laszlodaniel/CCDBusTransceiver/PCB/V300/schematic/CCDBusTransceiver_V300_schematic.pdf

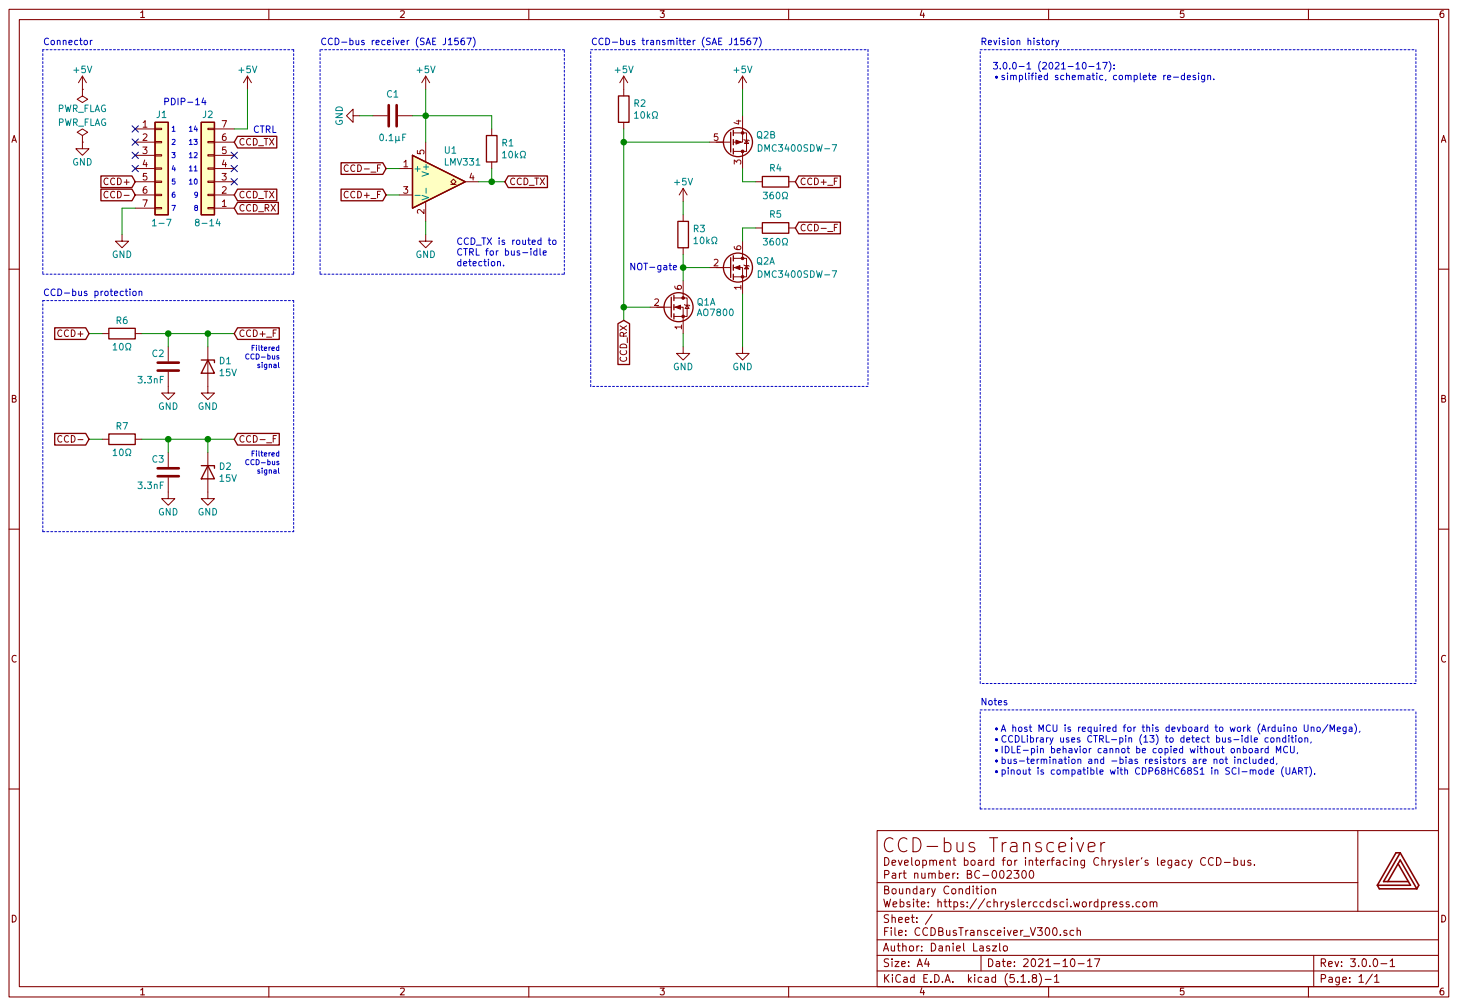
[picture p1: page 1]

CCD-bus transmitter (SAE J1567) 2

CCD-bus receiver (SAE J1567)

simplified schematic, complete re-design.

Filtered CCD-bus
signal Filtered CCD-bus

CCDLibrary uses CTRL-pin (13) to detect bus-idle condition,
IDLE-pin behavior cannot be copied without onboard MCU, bus-termination and -bias resistors are not included, pinout is compatible with CDP68HC68S1 in SCI-mode (UART).

CCD-bus Transceiver
Part number: BC-002300 Development board for interfacing Chrysler's legacy CCD-bus.

File: CCDBusTransceiver_V300.sch Sheet: / Boundary Condition Author: Daniel Laszlo Website: https://chryslerccdsci.wordpress.com
