laszlodaniel/CCDBusTransceiver/PCB/V103/schematic/CCDBusTransceiver_V103_schematic.pdf

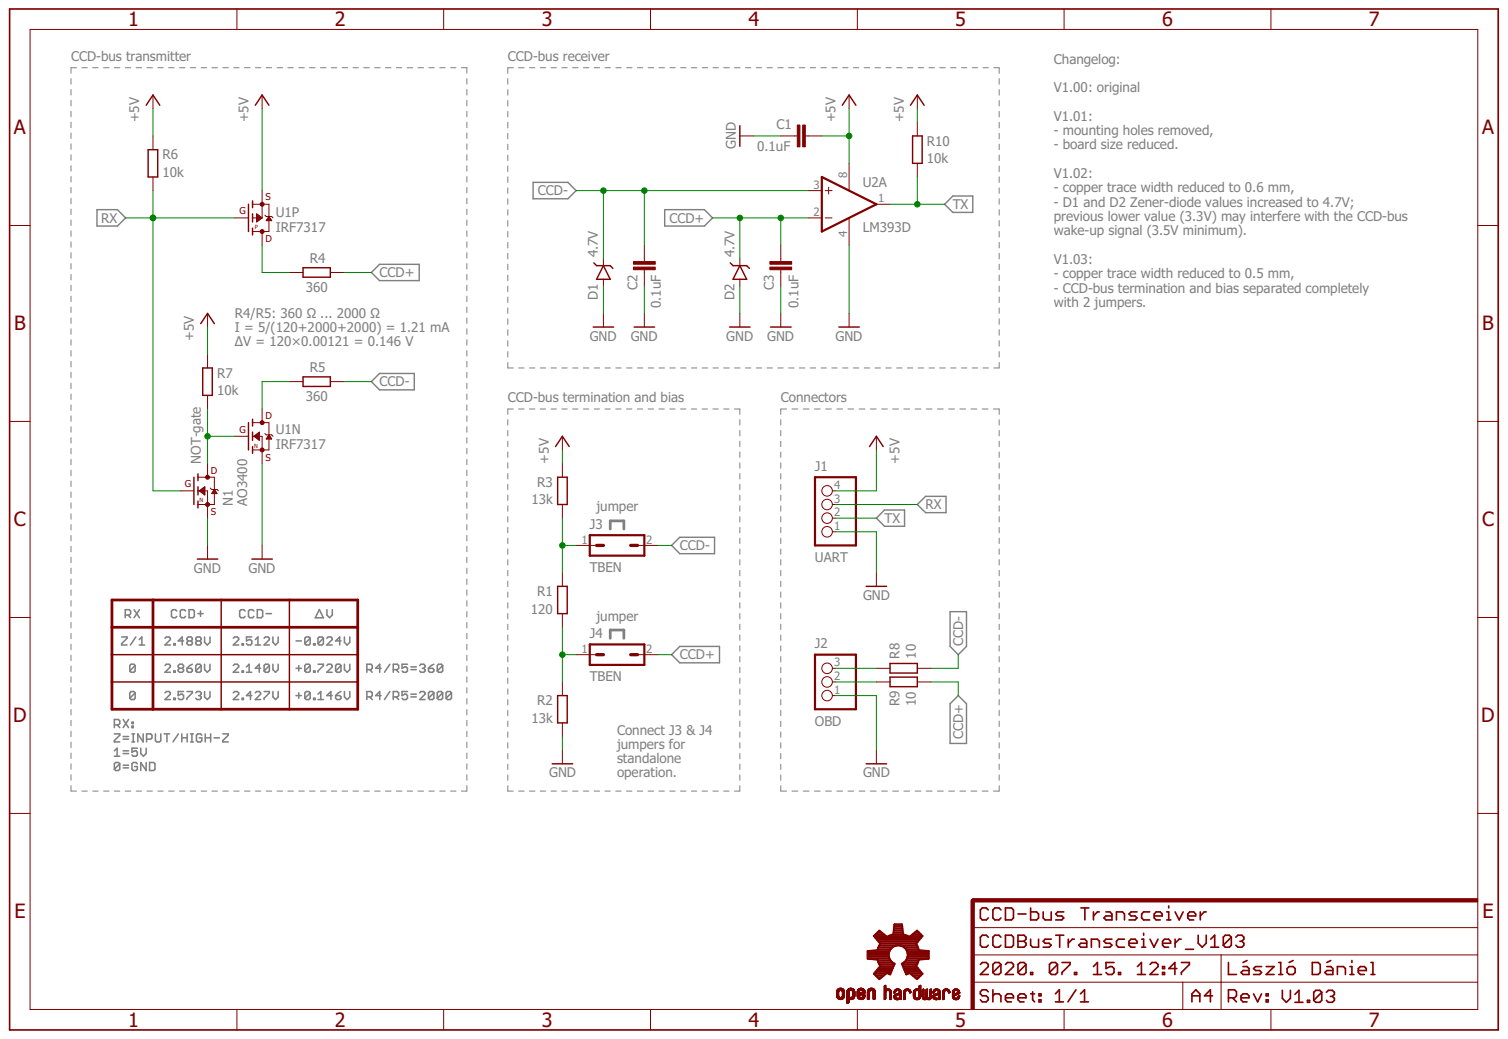
[picture p2: page 1]

CCD-bus transmitter | | CCD-bus receiver

V1.01: - mounting holes removed, - board size reduced. V1.02: - copper trace width reduced to 0.6 mm, - D1 and D2 Zener-diode values increased to 4.7V;

previous lower value (3.3V) may interfere with the CCD-bus wake-up signal (3.5V minimum). V1.03: - copper trace width reduced to 0.5 mm, - CCD-bus termination and bias separated completely with 2 jumpers. CCD-bus termination and bias

Connect J3 & J4
jumpers for standalone operation.
