laszlodaniel/CCDBusTransceiver/PCB/V101/schematic/CCDBusTransceiver_V101_schematic.pdf

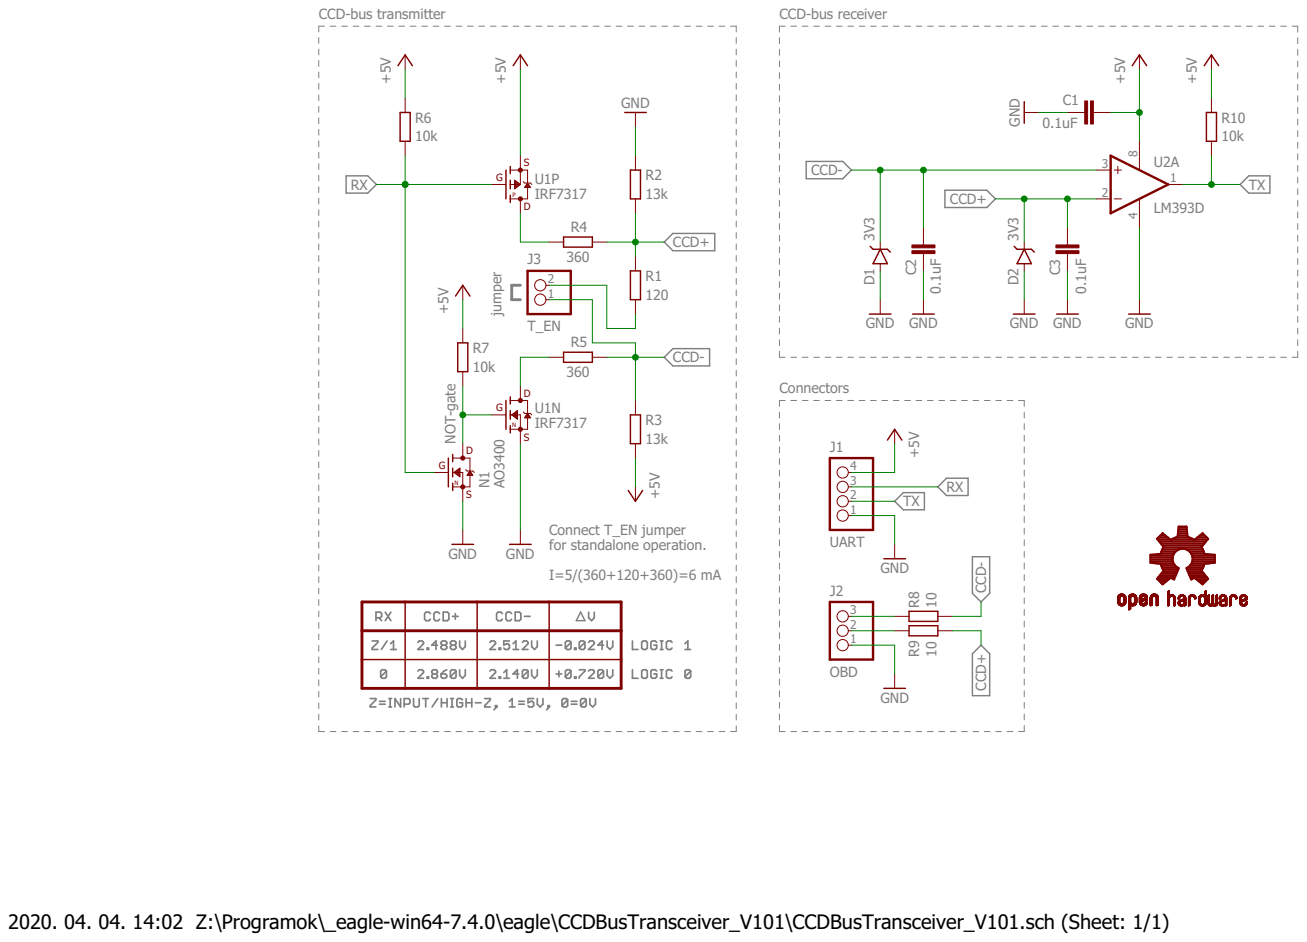
[picture p3: page 1]

Connect T_EN jumper
for standalone operation. I=5/(360+120+360)=6 mA

2020. 04. 04. 14:02 Z:\Programok\_eagle-win64-7.4.0\eagle\CCDBusTransceiver_V101\CCDBusTransceiver_V101.sch (Sheet: 1/1)
