laszlodaniel/CCDBusTransceiver/(threads)

Thread 1 (2020-04-23):

Inconsistent dominant voltage values (0-bit) among documentations

laszlodaniel, 2020-04-23:
From the CDP68HC68S1 datasheet (0.6V):
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

From another source (0.1V):
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

I think the latter is closer to reality. With R4 and R5 resistors this voltage drop across the termination resistor (R1) can be set easily.
