laszlodaniel/CCDBusTransceiver/(commit log)

2020-04-04 New PCB version
    Mounting holes removed, they are useless anyways. Routing optimized.
    [CCDBusTransceiver_V100.drills.xln, CCDBusTransceiver_V101.drills.xln]
2020-04-29 Update
    Arduino examples moved to the CCDLibrary repository.
    README.md updated.
2020-06-10 New PCB revision
    Minor changes. Check schematic for changelog.
    [CCDBusTransceiver_V102.drills.xln]
2020-07-17 Add V103 version
    [CCDBusTransceiver_V103.drills.xln]
2020-12-21 Update CCDBusTransceiver_V103_BOM.txt
    R4/R5 resistance values fixed at 360 Ohm. Package name clarified.
2021-06-13 Remove Gerber files
    [CCDBusTransceiver_V101.drills.xln, CCDBusTransceiver_V102.drills.xln, CCDBusTransceiver_V103.drills.xln]
2021-11-04 Add V3.00 schematic files
